idrilirdi/E-TKT/_electronic/kicad-lib/README.md

# Third-party KiCad libraries

- `Seeed_Studio_XIAO_Series.kicad_sym` and
  `Seeed_XIAO.pretty/XIAO-ESP32-C5-SMD.kicad_mod` come from
  [Seeed-Studio/OPL_Kicad_Library](https://github.com/Seeed-Studio/OPL_Kicad_Library),
  licensed CC-BY-SA-4.0.
