idrilirdi/E-TKT/docs/credits/libraries.md

---
layout: default
title: 📚 libraries
nav_order: 1
description: "E-TKT"
parent: 🏅 credits
---

# 📚 **libraries**

----

### Framework
- Arduino

### Environment
- Seeed XIAO ESP32-C5, [pioarduino platform-espressif32](https://github.com/pioarduino/platform-espressif32) 55.03.311 (arduino-esp32 3.3.11)

### Libraries
- [waspinator/AccelStepper@1.64](https://github.com/waspinator/AccelStepper )
- [madhephaestus/ESP32Servo@3.2.1](https://github.com/madhephaestus/ESP32Servo )
- [ESP32Async/ESPAsyncWebServer@3.12.1](https://github.com/ESP32Async/ESPAsyncWebServer)
- [ESP32Async/AsyncTCP@3.5.0](https://github.com/ESP32Async/AsyncTCP)
- [alanswx/ESPAsyncWiFiManager@0.31](https://github.com/alanswx/ESPAsyncWiFiManager)
- [olikraus/U8g2@2.36.18](https://github.com/olikraus/U8g2)
- [ricmoo/QRCode@0.0.1](https://github.com/ricmoo/QRCode) 
- [bblanchon/ArduinoJson@6.21.6](https://github.com/bblanchon/ArduinoJson)
- [ayushsharma82/ElegantOTA@3.1.7](https://github.com/ayushsharma82/ElegantOTA)

A big thank you for the library developers!
