idrilirdi/E-TKT/_electronic/e-tkt.kicad_pcb

## KiCad design _electronic/e-tkt.kicad_pcb (2026-11-04)

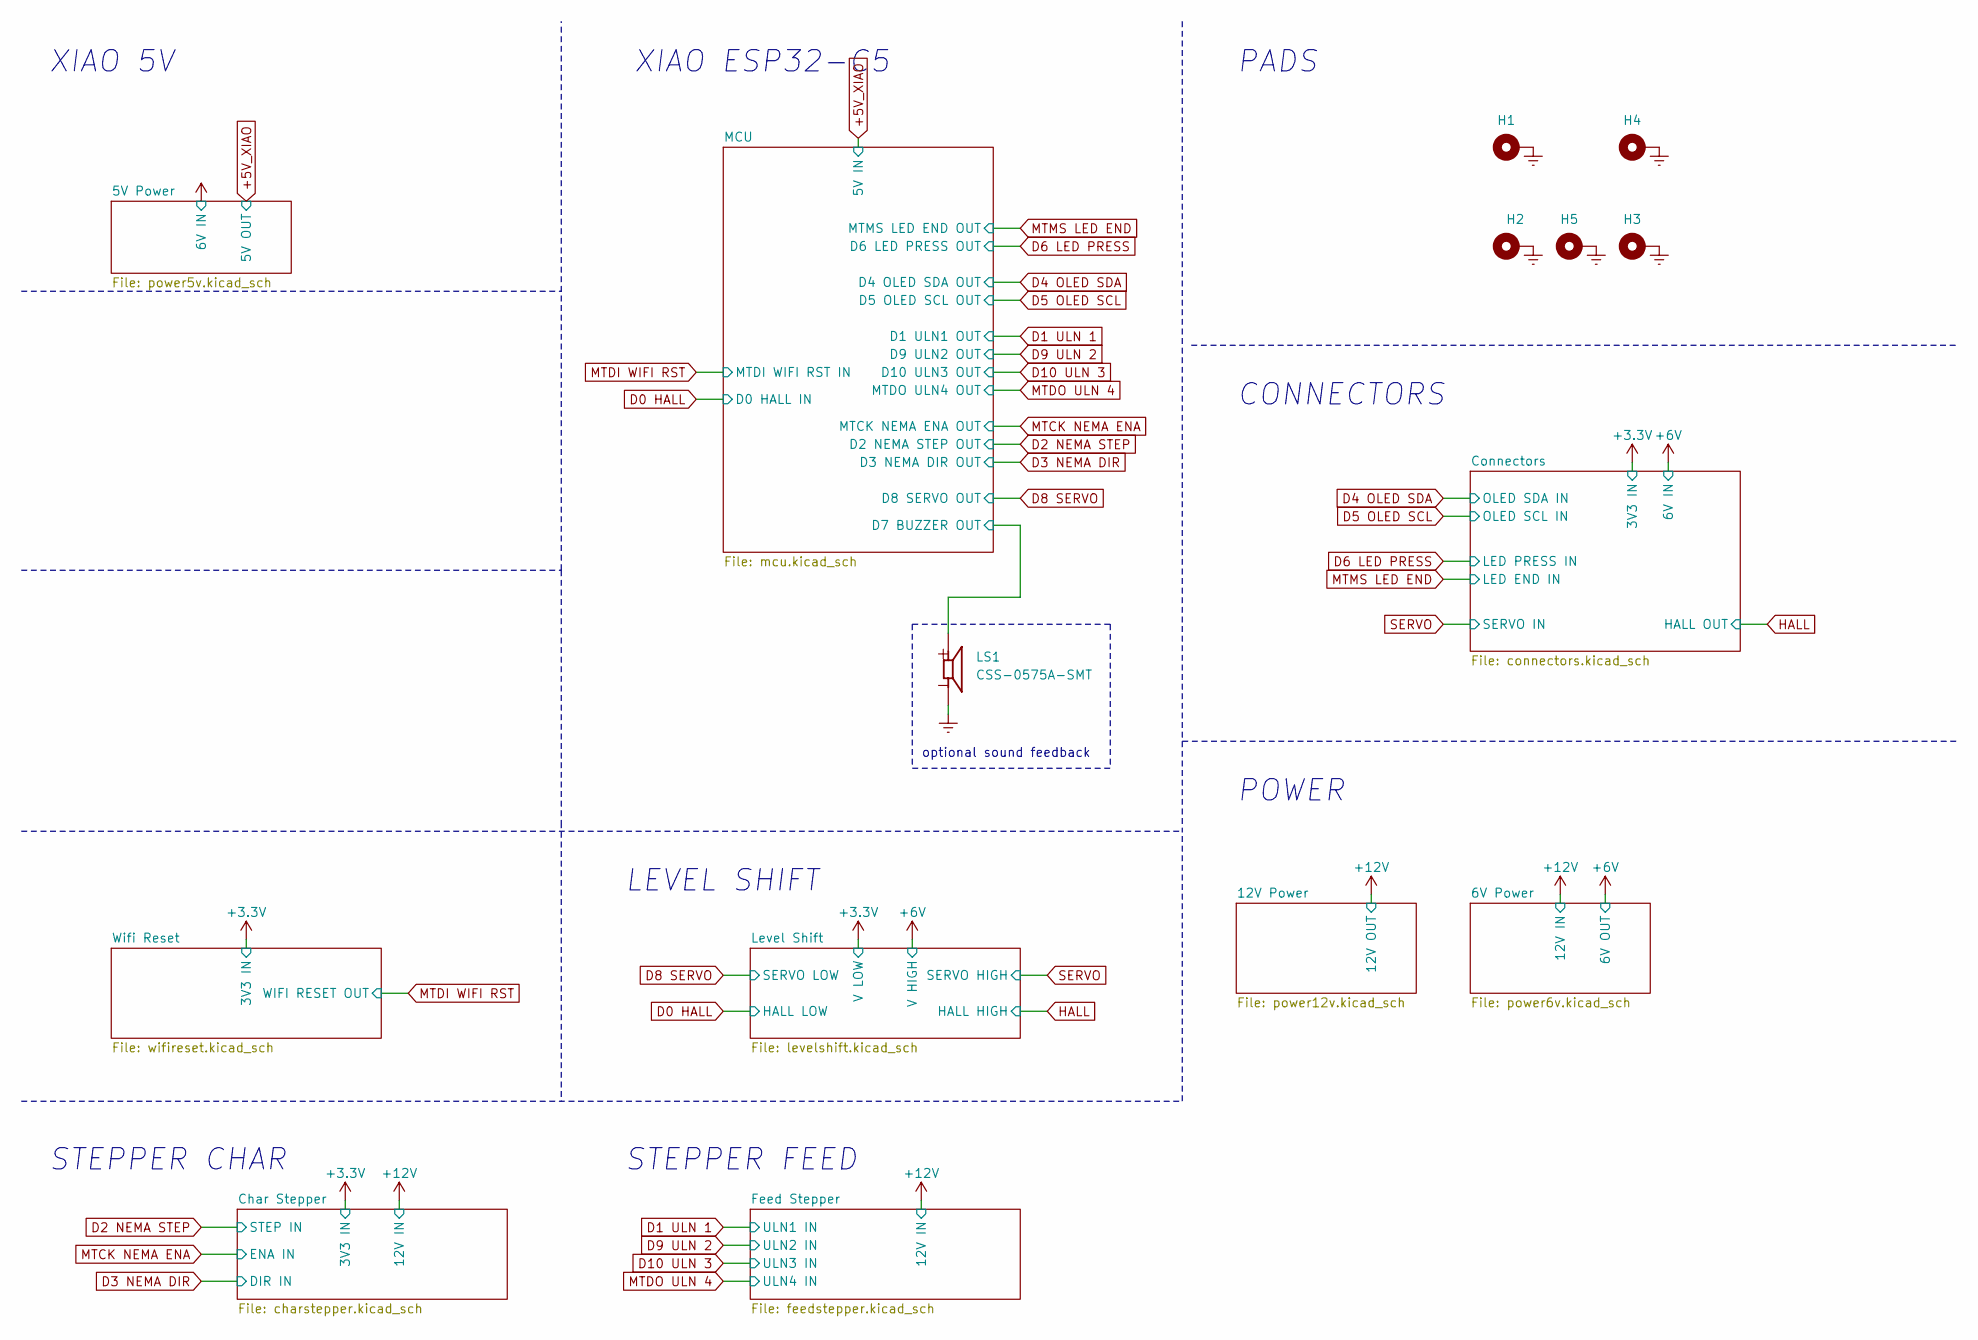
[picture p4: schematic e-tkt.kicad_sch, E-TKT v1.0]

Parts:
H1, H2, H3, H4, H5: M3; MountingHole_3.2mm_M3_Pad_Via; Mouser OK
LS1: CSS-0575A-SMT; CUI_CSS-0575A-SMT; Mouser OK

Connections:
/MCU/D7 BUZZER OUT: LS1.1; also elsewhere on the board
GNDREF: H1.1, H2.1, H3.1, H4.1, H5.1, LS1.2; also elsewhere on the board

Notes on the sheet:
PADS
POWER
optional sound feedback
CONNECTORS
STEPPER CHAR
XIAO ESP32-C5
LEVEL SHIFT
STEPPER FEED
XIAO 5V

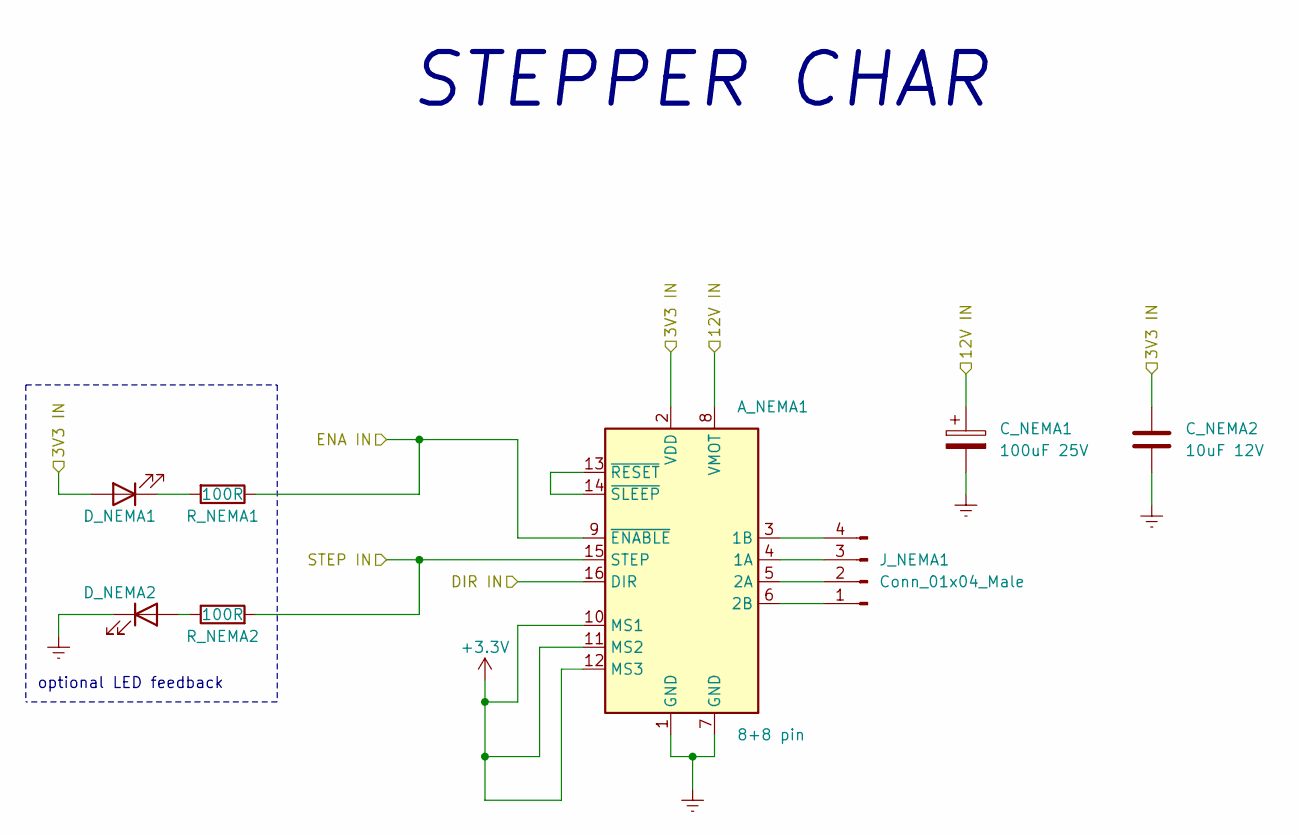
[picture p5: schematic charstepper.kicad_sch, E-TKT v1.0]

Parts:
A_NEMA1: 8+8 pin; Pololu_Breakout-16_15.2x20.3mm; Mouser OK
C_NEMA1: 100uF 25V; CP_Elec_6.3x7.7; Mouser OK
C_NEMA2: 10uF 12V; C_0603_1608Metric_Pad1.08x0.95mm_HandSolder; Mouser OK
D_NEMA1, D_NEMA2: LED white; LED_0603_1608Metric_Pad1.05x0.95mm_HandSolder; Mouser OK
J_NEMA1: Conn_01x04_Male; PinHeader_1x04_P2.54mm_Horizontal; Mouser OK
R_NEMA1, R_NEMA2: 100R; R_0603_1608Metric_Pad0.98x0.95mm_HandSolder; Mouser OK

Connections:
+3.3V: A_NEMA1.2 (VDD), A_NEMA1.10 (MS1), A_NEMA1.11 (MS2), A_NEMA1.12 (MS3), C_NEMA2.2, D_NEMA1.2 (A); also elsewhere on the board
+12V: A_NEMA1.8 (VMOT), C_NEMA1.1; also elsewhere on the board
D2 NEMA STEP: A_NEMA1.15 (STEP), R_NEMA2.2; also elsewhere on the board
D3 NEMA DIR: A_NEMA1.16 (DIR); also elsewhere on the board
GNDREF: A_NEMA1.1 (GND), A_NEMA1.7 (GND), C_NEMA1.2, C_NEMA2.1, D_NEMA2.1 (K); also elsewhere on the board
MTCK NEMA ENA: A_NEMA1.9 (~ENABLE), R_NEMA1.1; also elsewhere on the board
unnamed: A_NEMA1.4 (1A), J_NEMA1.3
unnamed: A_NEMA1.3 (1B), J_NEMA1.4
unnamed: A_NEMA1.5 (2A), J_NEMA1.2
unnamed: A_NEMA1.6 (2B), J_NEMA1.1
unnamed: A_NEMA1.13 (~RESET), A_NEMA1.14 (~SLEEP)
unnamed: D_NEMA1.1 (K), R_NEMA1.2
unnamed: D_NEMA2.2 (A), R_NEMA2.1

Notes on the sheet:
optional LED feedback
STEPPER CHAR

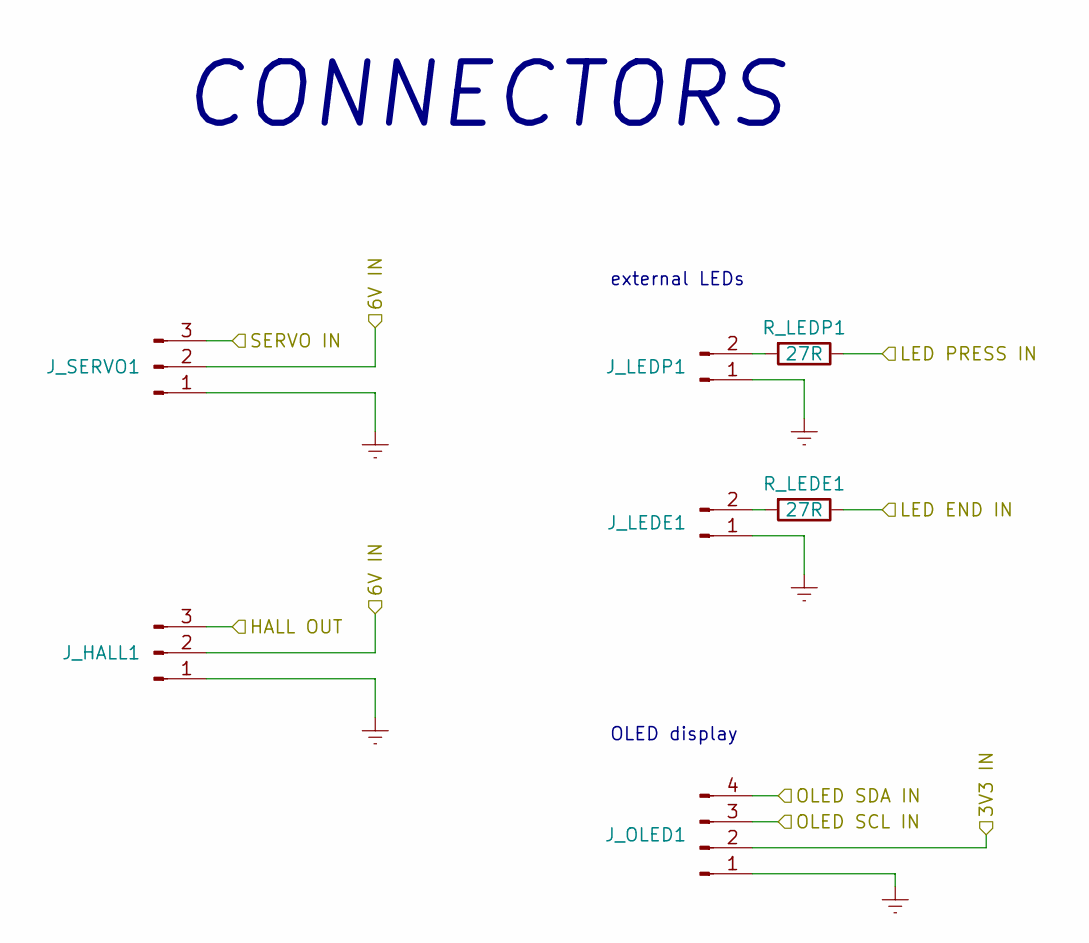
[picture p6: schematic connectors.kicad_sch, E-TKT v1.0]

Parts:
J_HALL1: Conn_01x03_Female; PinHeader_1x03_P2.54mm_Vertical; Mouser OK
J_LEDE1: Conn_01x02_Male; PinHeader_1x02_P2.54mm_Vertical; Mouser OK
J_LEDP1: Conn_01x02_Male; PinHeader_1x02_P2.54mm_Vertical; Mouser OK
J_OLED1: Conn_01x04_Male; PinHeader_1x04_P2.54mm_Vertical; Mouser OK
J_SERVO1: Conn_01x03_Male; PinHeader_1x03_P2.54mm_Vertical; Mouser OK
R_LEDE1: 27R; R_0603_1608Metric_Pad0.98x0.95mm_HandSolder; Mouser OK
R_LEDP1: 27R; R_0603_1608Metric_Pad0.98x0.95mm_HandSolder; Mouser OK

Connections:
+3.3V: J_OLED1.2; also elsewhere on the board
+6V: J_HALL1.2, J_SERVO1.2; also elsewhere on the board
D4 OLED SDA: J_OLED1.4; also elsewhere on the board
D5 OLED SCL: J_OLED1.3; also elsewhere on the board
D6 LED PRESS: R_LEDP1.1; also elsewhere on the board
GNDREF: J_HALL1.1, J_LEDE1.1, J_LEDP1.1, J_OLED1.1, J_SERVO1.1; also elsewhere on the board
HALL: J_HALL1.3; also elsewhere on the board
MTMS LED END: R_LEDE1.1; also elsewhere on the board
unnamed: J_LEDE1.2, R_LEDE1.2
unnamed: J_LEDP1.2, R_LEDP1.2
SERVO: J_SERVO1.3; also elsewhere on the board

Notes on the sheet:
OLED display
CONNECTORS
external LEDs

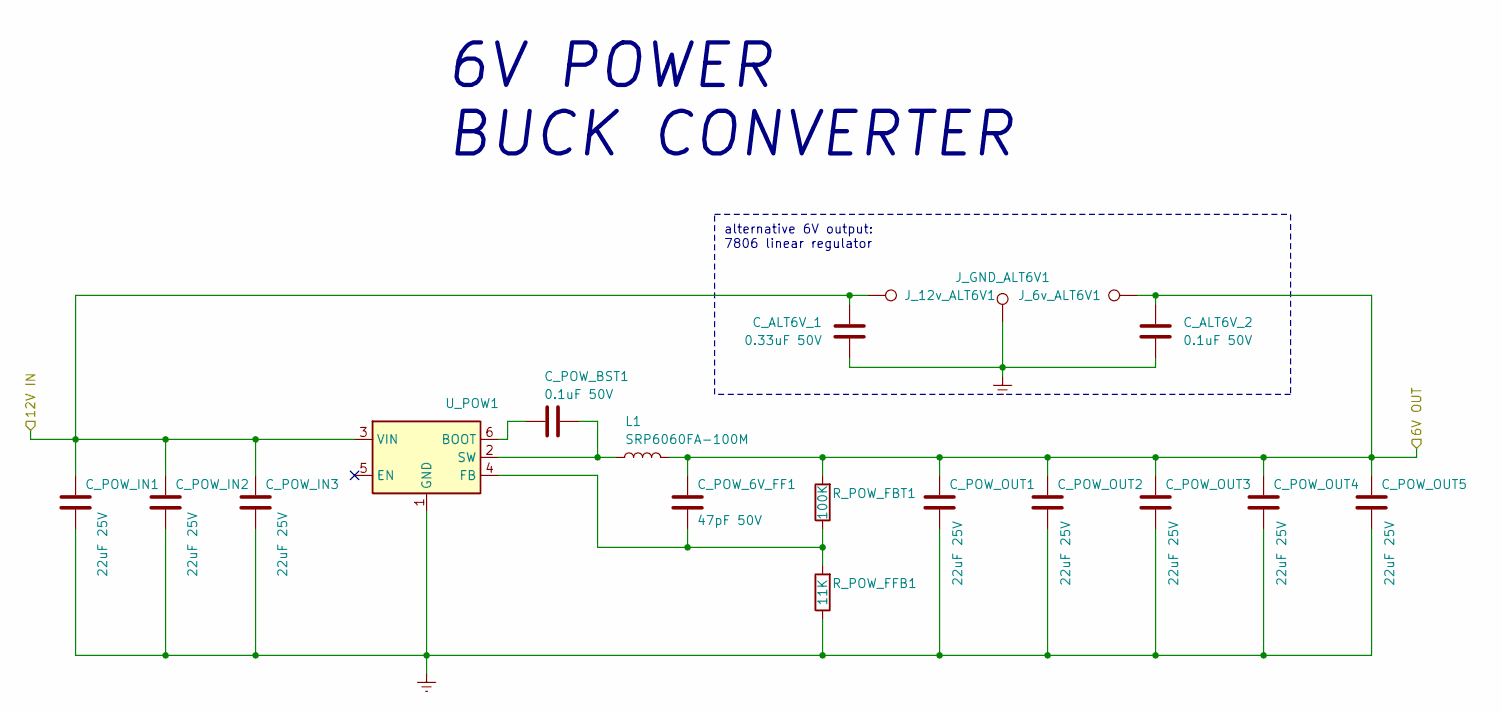
[picture p7: schematic power6v.kicad_sch, E-TKT v1.0]

Parts:
C_ALT6V_1: 0.33uF 50V; C_0603_1608Metric_Pad1.08x0.95mm_HandSolder; Mouser OK
C_ALT6V_2: 0.1uF 50V; C_0603_1608Metric_Pad1.08x0.95mm_HandSolder; Mouser OK
C_POW_6V_FF1: 47pF 50V; C_0603_1608Metric_Pad1.08x0.95mm_HandSolder; Mouser OK
C_POW_BST1: 0.1uF 50V; C_0603_1608Metric_Pad1.08x0.95mm_HandSolder; Mouser OK
C_POW_IN1, C_POW_IN2, C_POW_IN3: 22uF 25V; C_1210_3225Metric_Pad1.33x2.70mm_HandSolder; Mouser OK
C_POW_OUT1, C_POW_OUT2, C_POW_OUT3, C_POW_OUT4, C_POW_OUT5: 22uF 25V; C_1210_3225Metric_Pad1.33x2.70mm_HandSolder; Mouser OK
J_6v_ALT6V1, J_12v_ALT6V1: TestPoint; TestPoint_Pad_D1.5mm; Mouser OK
J_GND_ALT6V1: TestPoint; TestPoint_Pad_D1.5mm; Mouser OK
L1: SRP6060FA-100M; SRP6060FA-4R7M; Mouser OK
R_POW_FBT1: 100K; R_0603_1608Metric_Pad0.98x0.95mm_HandSolder; Mouser OK
R_POW_FFB1: 11K; R_0603_1608Metric_Pad0.98x0.95mm_HandSolder; Mouser OK
U_POW1: SOT-23-6_Handsoldering; Mouser N

Connections:
+6V: C_ALT6V_2.1, C_POW_6V_FF1.1, C_POW_OUT1.1, C_POW_OUT2.1, C_POW_OUT3.1, C_POW_OUT4.1, C_POW_OUT5.1, J_6v_ALT6V1.1, L1.2, R_POW_FBT1.2; also elsewhere on the board
+12V: C_ALT6V_1.2, C_POW_IN1.1, C_POW_IN2.1, C_POW_IN3.1, J_12v_ALT6V1.1, U_POW1.3 (VIN); also elsewhere on the board
GNDREF: C_ALT6V_1.1, C_ALT6V_2.2, C_POW_IN1.2, C_POW_IN2.2, C_POW_IN3.2, C_POW_OUT1.2, C_POW_OUT2.2, C_POW_OUT3.2, C_POW_OUT4.2, C_POW_OUT5.2, J_GND_ALT6V1.1, R_POW_FFB1.1, U_POW1.1 (GND); also elsewhere on the board
unnamed: C_POW_BST1.1, U_POW1.6 (BOOT)
unnamed: C_POW_6V_FF1.2, R_POW_FBT1.1, R_POW_FFB1.2, U_POW1.4 (FB)
unnamed: C_POW_BST1.2, L1.1, U_POW1.2 (SW)

Notes on the sheet:
alternative 6V output: 7806 linear regulator
6V POWER BUCK CONVERTER

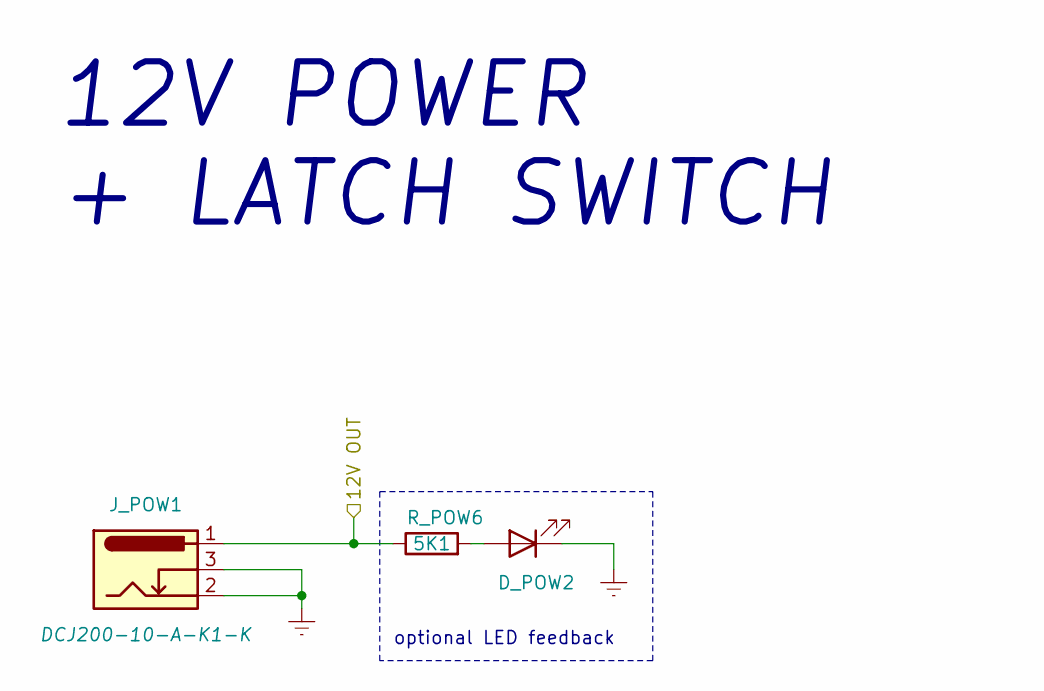
[picture p8: schematic power12v.kicad_sch, E-TKT v1.0]

Parts:
D_POW2: LED white; LED_0603_1608Metric_Pad1.05x0.95mm_HandSolder; Mouser OK
J_POW1: Barrel_Jack_Switch; BarrelJack_GCT_DCJ200-10-A_Horizontal; Mouser OK
R_POW6: 5K1; R_0603_1608Metric_Pad0.98x0.95mm_HandSolder; Mouser OK

Connections:
+12V: J_POW1.1, R_POW6.1; also elsewhere on the board
GNDREF: D_POW2.1 (K), J_POW1.2, J_POW1.3; also elsewhere on the board
unnamed: D_POW2.2 (A), R_POW6.2

Notes on the sheet:
optional LED feedback
12V POWER + LATCH SWITCH

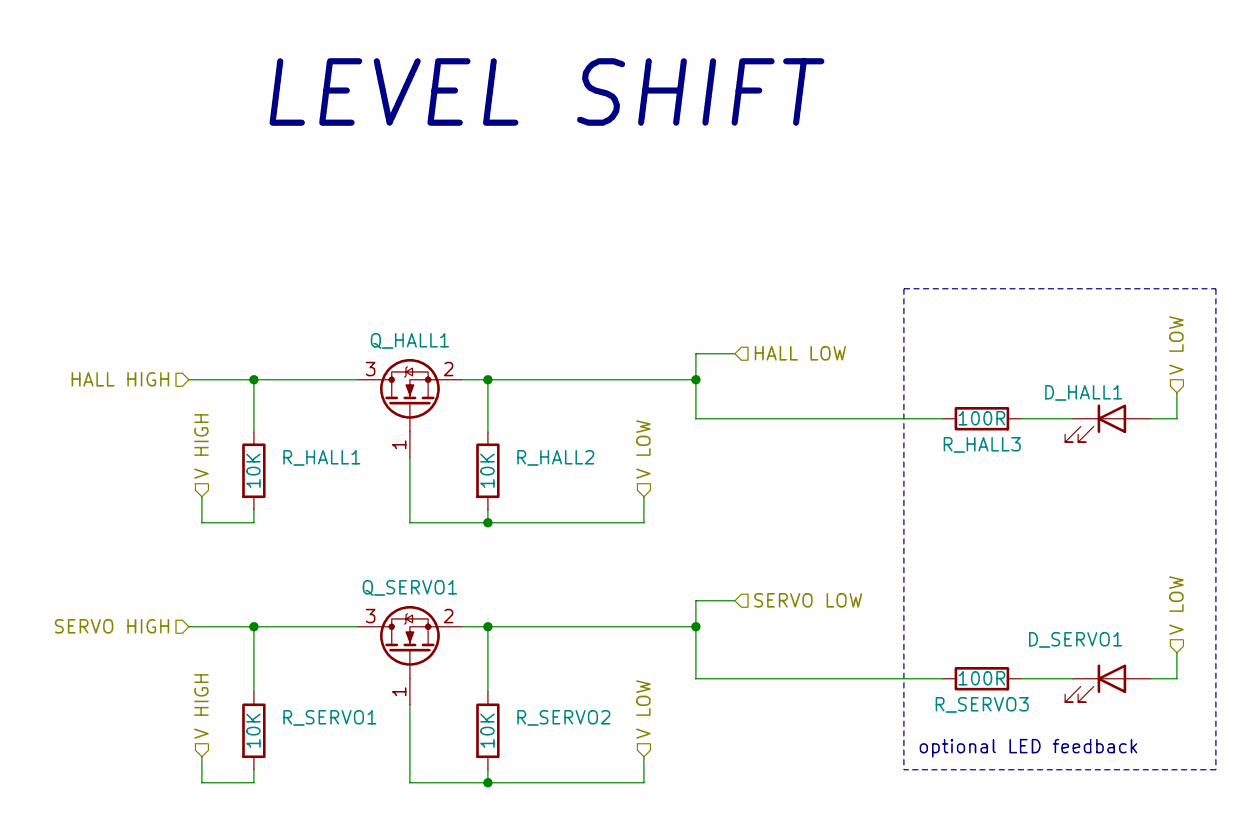
[picture p9: schematic levelshift.kicad_sch, E-TKT v1.0]

Parts:
D_HALL1: LED white; LED_0603_1608Metric_Pad1.05x0.95mm_HandSolder; Mouser OK
D_SERVO1: LED white; LED_0603_1608Metric_Pad1.05x0.95mm_HandSolder; Mouser OK
Q_HALL1: BSS138LT3G; SOT-23_Handsoldering; Mouser OK
Q_SERVO1: BSS138LT3G; SOT-23_Handsoldering; Mouser OK
R_HALL1, R_HALL2: 10K; R_0603_1608Metric_Pad0.98x0.95mm_HandSolder; Mouser OK
R_HALL3: 100R; R_0603_1608Metric_Pad0.98x0.95mm_HandSolder; Mouser OK
R_SERVO1, R_SERVO2: 10K; R_0603_1608Metric_Pad0.98x0.95mm_HandSolder; Mouser OK
R_SERVO3: 100R; R_0603_1608Metric_Pad0.98x0.95mm_HandSolder; Mouser OK

Connections:
+3.3V: D_HALL1.2 (A), D_SERVO1.2 (A), Q_HALL1.1 (G), Q_SERVO1.1 (G), R_HALL2.2, R_SERVO2.2; also elsewhere on the board
+6V: R_HALL1.2, R_SERVO1.2; also elsewhere on the board
D0 HALL: Q_HALL1.2 (S), R_HALL2.1, R_HALL3.1; also elsewhere on the board
D8 SERVO: Q_SERVO1.2 (S), R_SERVO2.1, R_SERVO3.1; also elsewhere on the board
HALL: Q_HALL1.3 (D), R_HALL1.1; also elsewhere on the board
unnamed: D_HALL1.1 (K), R_HALL3.2
unnamed: D_SERVO1.1 (K), R_SERVO3.2
SERVO: Q_SERVO1.3 (D), R_SERVO1.1; also elsewhere on the board

Notes on the sheet:
optional LED feedback
LEVEL SHIFT

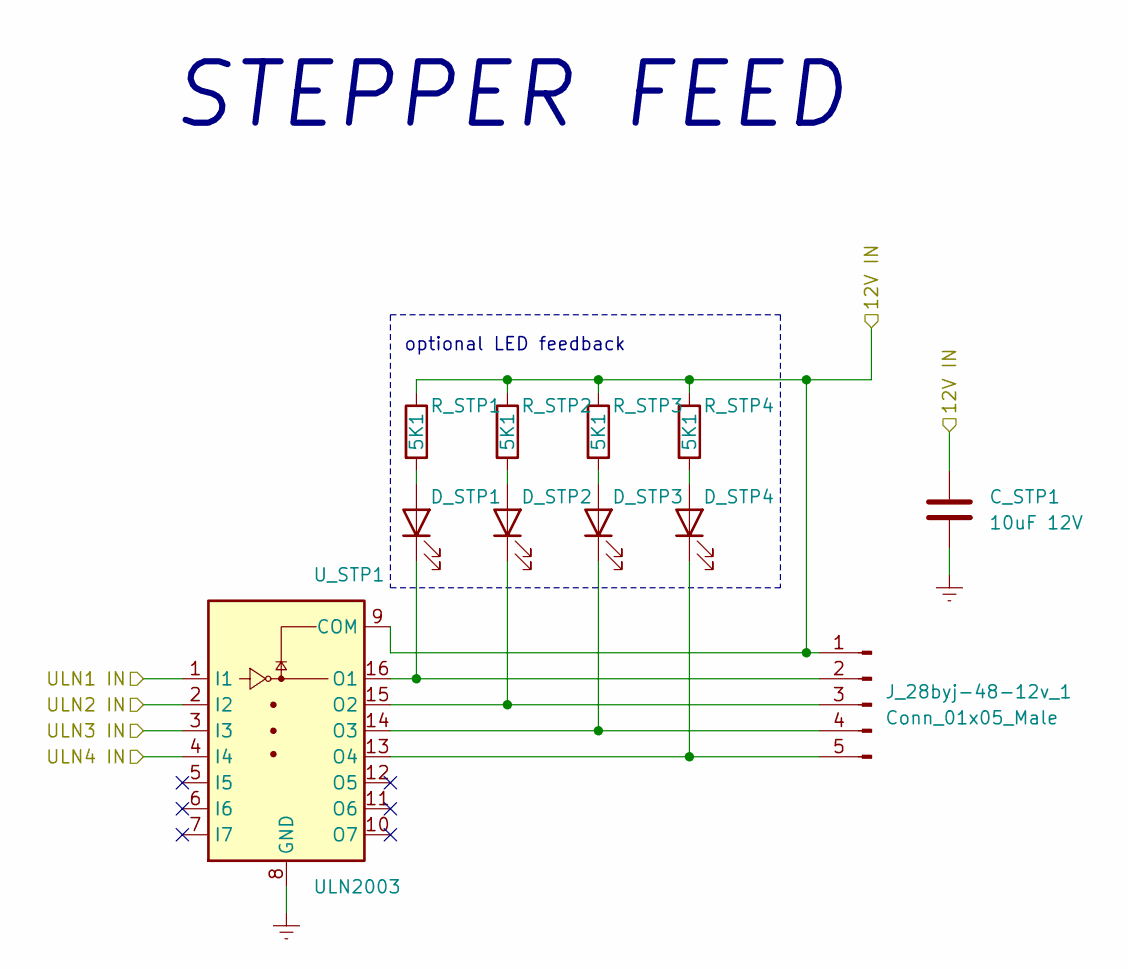
[picture p10: schematic feedstepper.kicad_sch, E-TKT v1.0]

Parts:
C_STP1: 10uF 12V; C_0603_1608Metric_Pad1.08x0.95mm_HandSolder; Mouser OK
D_STP1, D_STP2, D_STP3, D_STP4: LED white; LED_0603_1608Metric_Pad1.05x0.95mm_HandSolder; Mouser OK
J_28byj-48-12v_1: Conn_01x05_Male; PinHeader_1x05_P2.54mm_Vertical; Mouser OK
R_STP1, R_STP2, R_STP3, R_STP4: 5K1; R_0603_1608Metric_Pad0.98x0.95mm_HandSolder; Mouser OK
U_STP1: ULN2003; SOIC-16_3.9x9.9mm_P1.27mm; Mouser OK

Connections:
+12V: C_STP1.2, J_28byj-48-12v_1.1, R_STP1.1, R_STP2.1, R_STP3.1, R_STP4.1, U_STP1.9 (COM); also elsewhere on the board
D1 ULN 1: U_STP1.1 (I1); also elsewhere on the board
D9 ULN 2: U_STP1.2 (I2); also elsewhere on the board
D10 ULN 3: U_STP1.3 (I3); also elsewhere on the board
GNDREF: C_STP1.1, U_STP1.8 (GND); also elsewhere on the board
MTDO ULN 4: U_STP1.4 (I4); also elsewhere on the board
unnamed: D_STP1.2 (A), R_STP1.2
unnamed: D_STP1.1 (K), J_28byj-48-12v_1.2, U_STP1.16 (O1)
unnamed: D_STP2.2 (A), R_STP2.2
unnamed: D_STP2.1 (K), J_28byj-48-12v_1.3, U_STP1.15 (O2)
unnamed: D_STP3.2 (A), R_STP3.2
unnamed: D_STP3.1 (K), J_28byj-48-12v_1.4, U_STP1.14 (O3)
unnamed: D_STP4.2 (A), R_STP4.2
unnamed: D_STP4.1 (K), J_28byj-48-12v_1.5, U_STP1.13 (O4)

Notes on the sheet:
optional LED feedback
STEPPER FEED

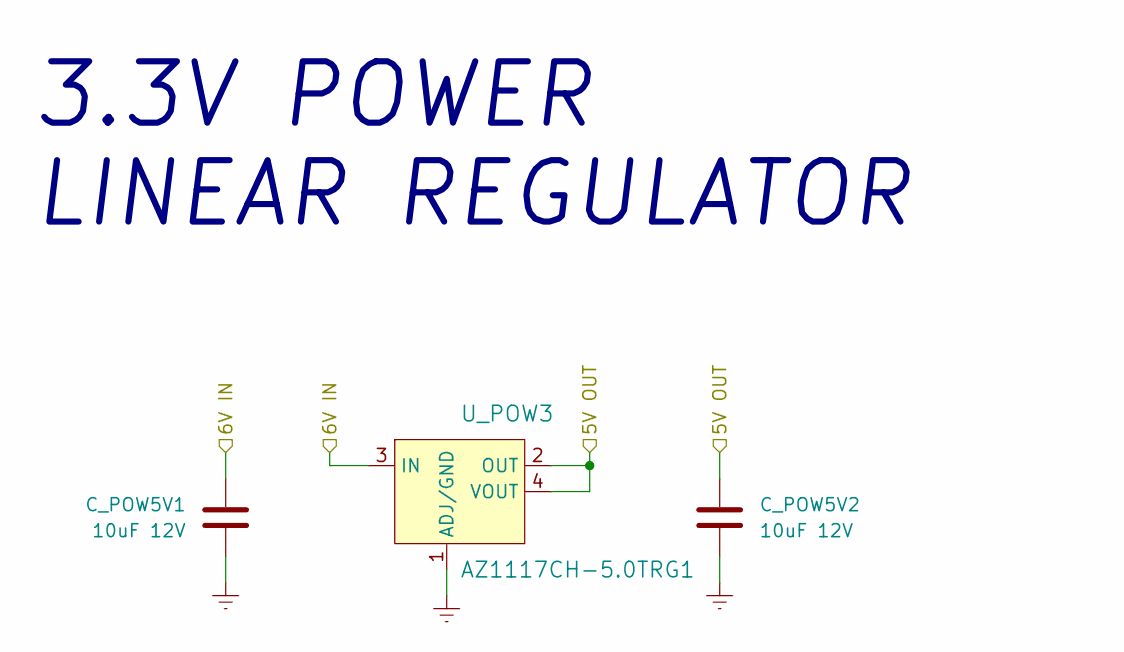
[picture p11: schematic power5v.kicad_sch, E-TKT v1.0]

Parts:
C_POW5V1, C_POW5V2: 10uF 12V; C_0603_1608Metric_Pad1.08x0.95mm_HandSolder; Mouser OK
U_POW3: AZ1117CH-5.0TRG1; SOT-223; Mouser OK

Connections:
+5V_XIAO: C_POW5V2.1, U_POW3.2 (OUT), U_POW3.4 (VOUT); also elsewhere on the board
+6V: C_POW5V1.1, U_POW3.3 (IN); also elsewhere on the board
GNDREF: C_POW5V1.2, C_POW5V2.2, U_POW3.1 (ADJ/GND); also elsewhere on the board

Notes on the sheet:
3.3V POWER LINEAR REGULATOR

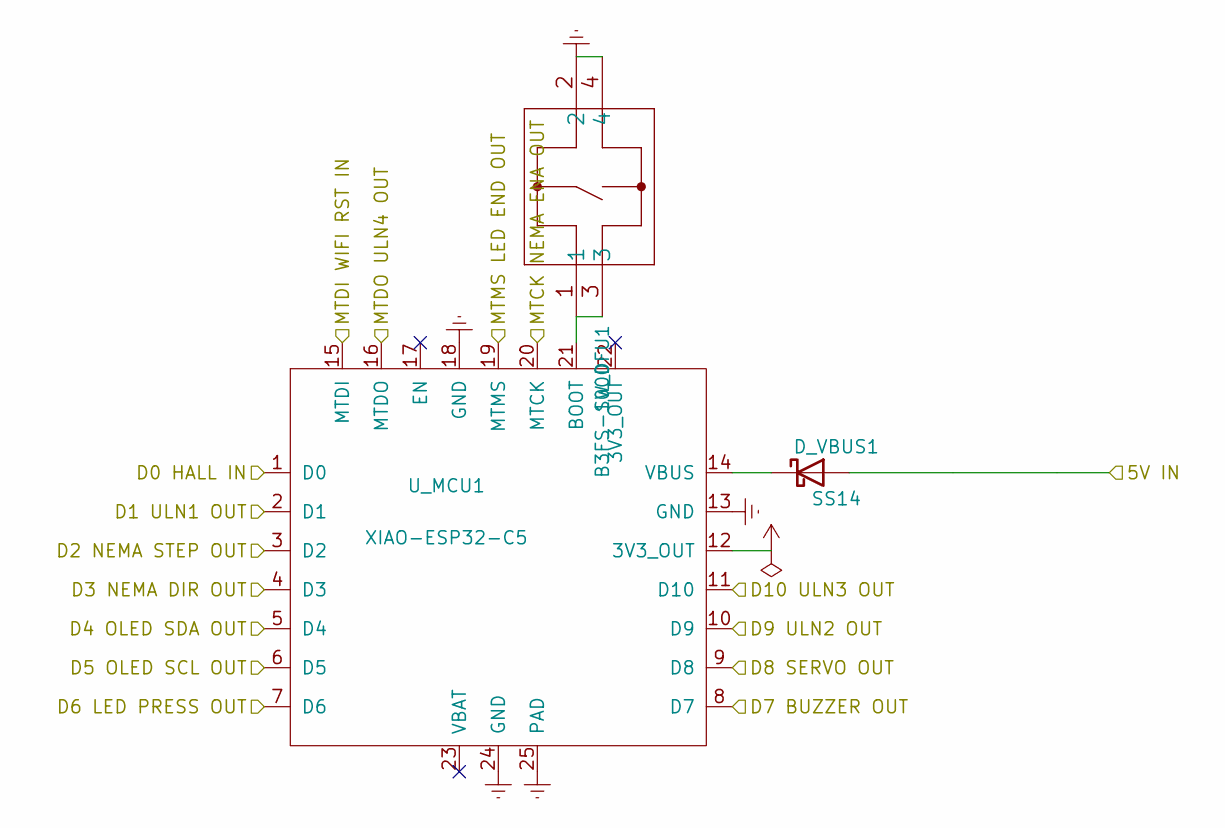
[picture p12: schematic mcu.kicad_sch, E-TKT v1.0]

Parts:
D_VBUS1: SS14; D_SMA
SW_DFU1: B3FS-1000
U_MCU1: XIAO-ESP32-C5; XIAO-ESP32-C5-SMD

Connections:
+3.3V: U_MCU1.12 (3V3_OUT); also elsewhere on the board
+5V_XIAO: D_VBUS1.2 (A); also elsewhere on the board
/MCU/D7 BUZZER OUT: U_MCU1.8 (D7); also elsewhere on the board
D0 HALL: U_MCU1.1 (D0); also elsewhere on the board
D1 ULN 1: U_MCU1.2 (D1); also elsewhere on the board
D2 NEMA STEP: U_MCU1.3 (D2); also elsewhere on the board
D3 NEMA DIR: U_MCU1.4 (D3); also elsewhere on the board
D4 OLED SDA: U_MCU1.5 (D4); also elsewhere on the board
D5 OLED SCL: U_MCU1.6 (D5); also elsewhere on the board
D6 LED PRESS: U_MCU1.7 (D6); also elsewhere on the board
D8 SERVO: U_MCU1.9 (D8); also elsewhere on the board
D9 ULN 2: U_MCU1.10 (D9); also elsewhere on the board
D10 ULN 3: U_MCU1.11 (D10); also elsewhere on the board
GNDREF: SW_DFU1.2, SW_DFU1.4, U_MCU1.13 (GND), U_MCU1.18 (GND), U_MCU1.24 (GND), U_MCU1.25 (PAD); also elsewhere on the board
MTCK NEMA ENA: U_MCU1.20 (MTCK); also elsewhere on the board
MTDI WIFI RST: U_MCU1.15 (MTDI); also elsewhere on the board
MTDO ULN 4: U_MCU1.16 (MTDO); also elsewhere on the board
MTMS LED END: U_MCU1.19 (MTMS); also elsewhere on the board
unnamed: D_VBUS1.1 (K), U_MCU1.14 (VBUS)
unnamed: SW_DFU1.1, SW_DFU1.3, U_MCU1.21 (BOOT)

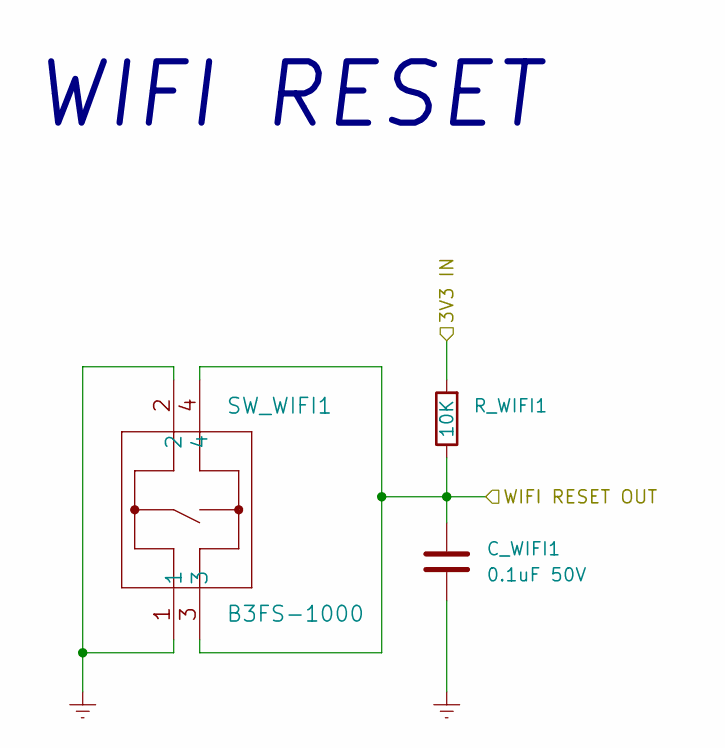
[picture p13: schematic wifireset.kicad_sch, E-TKT v1.0]

Parts:
C_WIFI1: 0.1uF 50V; C_0603_1608Metric_Pad1.08x0.95mm_HandSolder; Mouser OK
R_WIFI1: 10K; R_0603_1608Metric_Pad0.98x0.95mm_HandSolder; Mouser OK
SW_WIFI1: B3FS-1000; Mouser OK

Connections:
+3.3V: R_WIFI1.2; also elsewhere on the board
GNDREF: C_WIFI1.1, SW_WIFI1.1, SW_WIFI1.2; also elsewhere on the board
MTDI WIFI RST: C_WIFI1.2, R_WIFI1.1, SW_WIFI1.3, SW_WIFI1.4; also elsewhere on the board

Notes on the sheet:
WIFI RESET

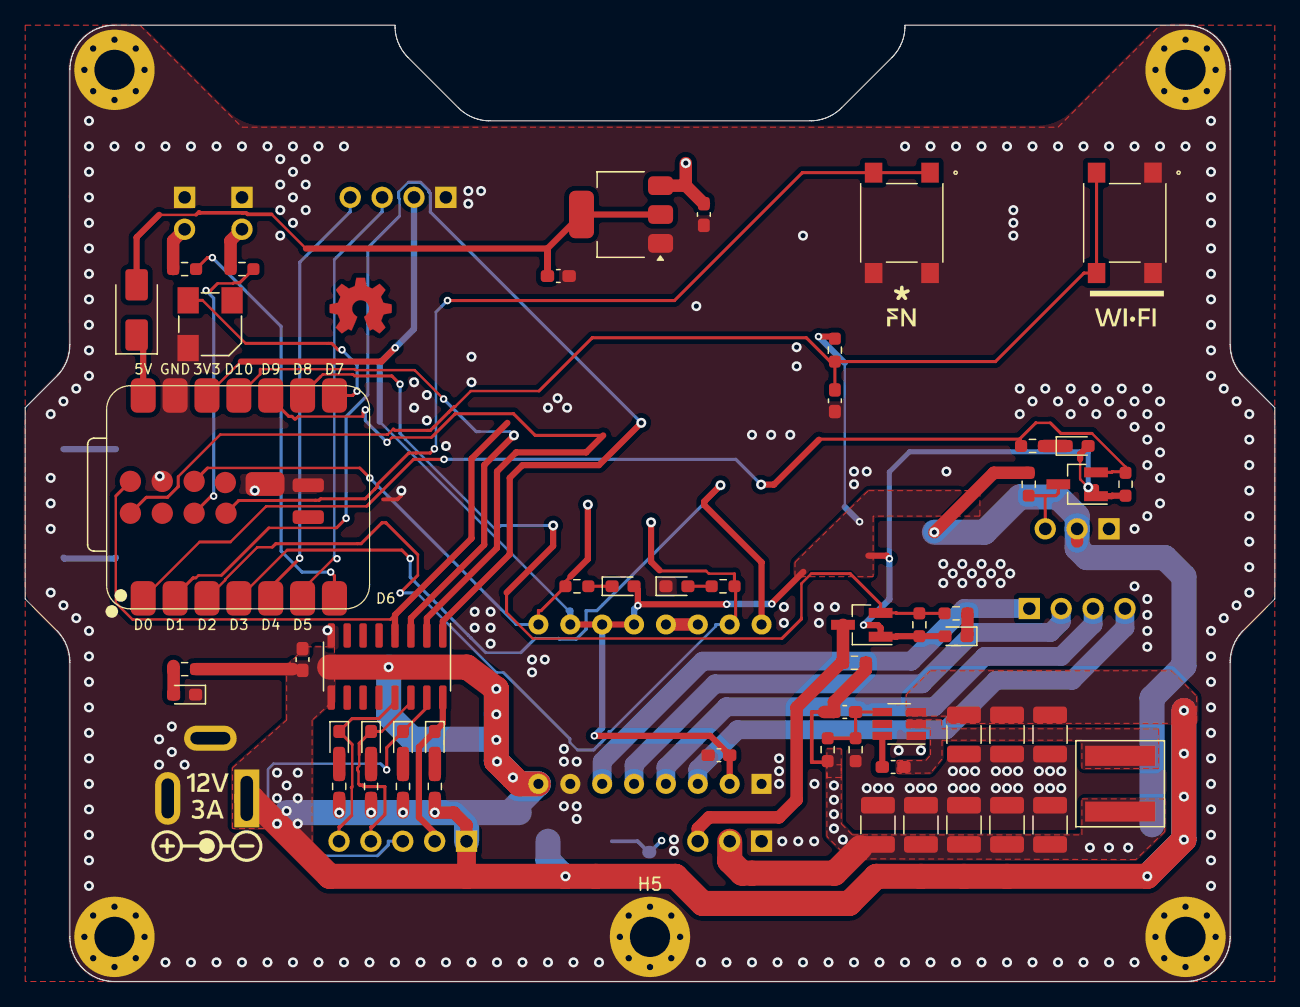
[picture p14: board e-tkt.kicad_pcb from above]

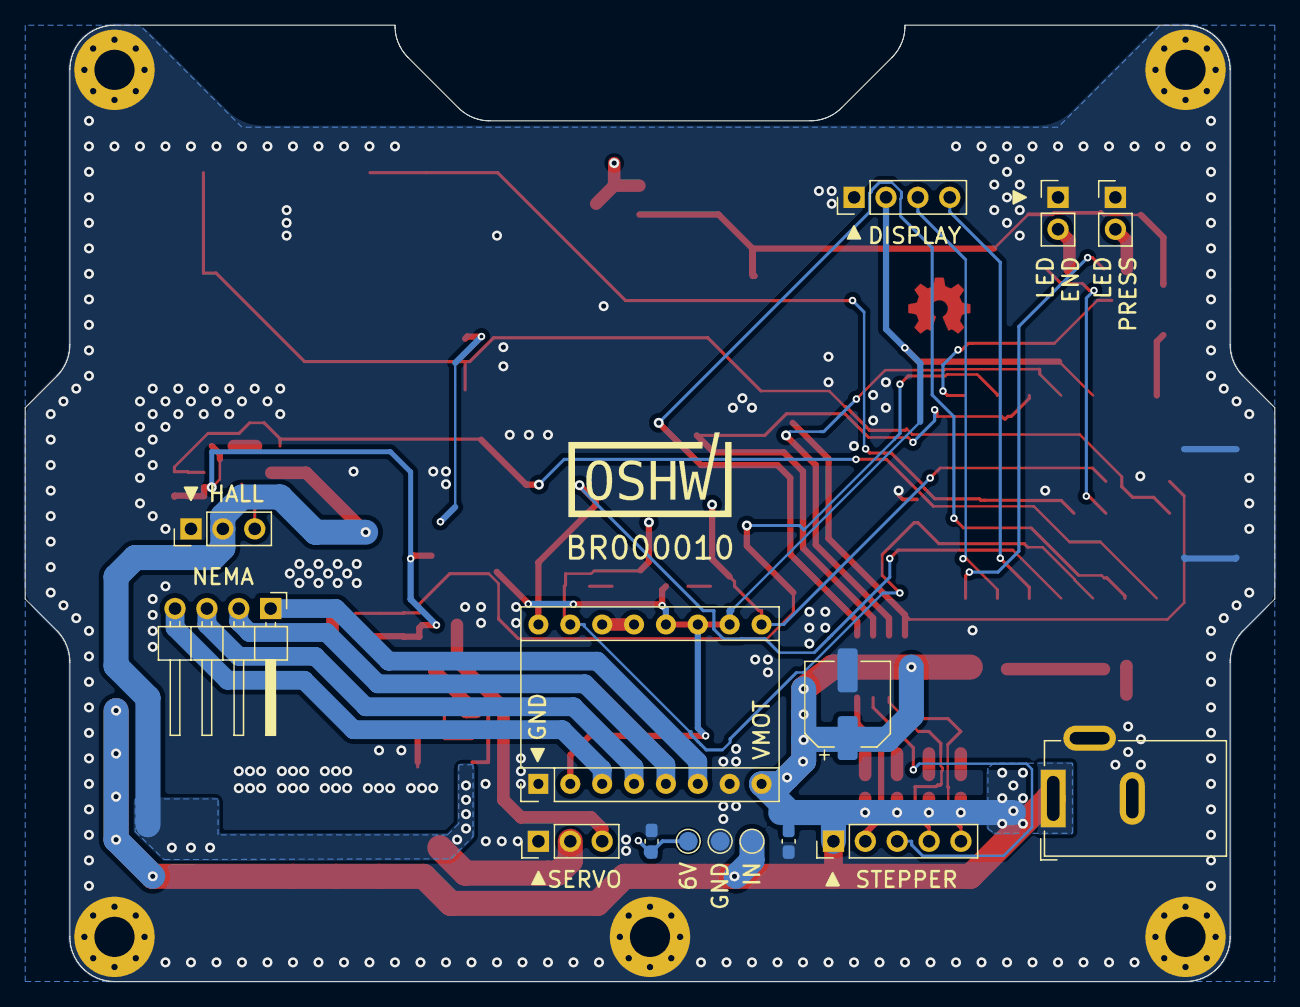
[picture p15: board e-tkt.kicad_pcb from below]

Board: 4 copper layers, 99.6 x 76.2 mm, 73 parts (15 on the bottom side), 47 nets.
