idrilirdi/E-TKT/src/LabelMaker.cpp

// MIT License

// Copyright (c) 2022 Andrei Speridião

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
//
// for more information, please visit https://github.com/andreisperid/E-TKT
//

// vvvvvvvvvvvvvvvvvvvvvvvvvvvvvvvvvvvvvvvvvvvvvvvvvvvvvvvvvvvvvvvvvvvvvvvvvv
//
// IMPORTANT: do not forget to upload the files in "data" folder using SPIFFS
//
// ^^^^^^^^^^^^^^^^^^^^^^^^^^^^^^^^^^^^^^^^^^^^^^^^^^^^^^^^^^^^^^^^^^^^^^^^^^

#include <Arduino.h>

#include "DaisyWheel.h"
#include "Characters.h"
#include "Configuration.h"
#include "Display.h"
#include "ETKT.h"
#include "Feeder.h"
#include "HallSwitch.h"
#include "Light.h"
#include "Logger.h"
#include "WebInterface.h"
#include "Press.h"
#include "Settings.h"
#include "Sound.h"
#include "Utility.h"

Logger* logger = new Logger();
Characters* characters = new Characters();
Sound* sound = new Sound(characters);
Display* display = new Display(sound, characters);
Settings* settings = new Settings(logger);
Light* ledFinish = new Light(FINISH_LED_PIN);
Light* ledChar = new Light(CHARACTER_LED_PIN);
Press* press = new Press(logger, SERVO_PIN, ledChar);
HallSwitch* hall = new HallSwitch(logger, HALL_PIN);
DaisyWheel* daisywheel = new DaisyWheel(logger, hall, characters, settings);
Feeder* feeder = new Feeder(logger);
ETKT* etkt = new ETKT(logger, settings, characters, display, daisywheel, hall,
                      feeder, press, sound, ledFinish, ledChar);
WebInterface* network = new WebInterface(logger, display, etkt, WIFI_RESET_PIN);

void setup() {
  // Initialize hardware
  etkt->initialize();

  // Play the splash screen
  display->playSplashScreen();

  // Start WiFi, network.
  network->initialize();

  // Display the ready "idle" screen.
  display->renderIdle();
}

void loop() {
  etkt->loop();
  network->loop();
}
