idrilirdi/E-TKT/src/WebInterface.h

#pragma once

#include <Arduino.h>
#include <AsyncTCP.h>
#include <ESPAsyncWebServer.h>
#include <ESPAsyncWiFiManager.h>
#include <ESPmDNS.h>
#include <WiFi.h>

#include "ArduinoJson.h"
#include "AsyncJson.h"
#include "Configuration.h"
#include "Display.h"
#include "ETKT.h"
#include "Logger.h"
#include "SPIFFS.h"
#include "esp_wifi.h"

/**
 * @brief Manages connection to the network. 
 * 
 * @details Handles:
 *  - Setting up WiFi credentials, including creating a soft AP for
 *    configuration
 *  - Serving the web interface and API endpoints
 *  - Advertising the device over MDNS.
 */
class WebInterface {
 private:
  // A hacky static workaround to make the softAPCallbackStatic method work.
  // Needed because of how the ESPAsyncWiFiManager library works.
  static WebInterface *instance;

  Logger *logger;
  AsyncWebServer *server;
  DNSServer *dns;
  Display *display;
  ETKT *etkt;

  // WiFi reset button pin
  uint8_t resetPin;

  /**
   * @brief A callback for when the captive portal is started.
   */
  void softAPCallback(AsyncWiFiManager *wifi);
  static void softAPCallbackStatic(AsyncWiFiManager *myAsyncWiFiManager);

  /*
   * @brief Clears stored wifi credentials in response to a button press.
   */
  void clearWiFiCredentials();

  /**
   * Callbacks to handle each type of command form the webapp.
   */
  void cutPostHandler(AsyncWebServerRequest *request);
  void reelPostHandler(AsyncWebServerRequest *request);
  void feedPostHandler(AsyncWebServerRequest *request);
  void savePostHandler(AsyncWebServerRequest *request, JsonVariant &json);
  void testAlignPostHandler(AsyncWebServerRequest *request, JsonVariant &json);
  void testFullPostHandler(AsyncWebServerRequest *request, JsonVariant &json);
  void homePostHandler(AsyncWebServerRequest *request);
  void movePostHandler(AsyncWebServerRequest *request, JsonVariant &json);
  void tagPostHandler(AsyncWebServerRequest *request, JsonVariant &json);
  void statusGetHandler(AsyncWebServerRequest *request);
  void notFoundHandler(AsyncWebServerRequest *request);

 public:
  WebInterface(Logger *logger, Display *display, ETKT *etkt, uint8_t resetPin);
  ~WebInterface();

  /**
   * Connects to the network, starts the captive portal if necessary, and starst
   * the webapp's server.
   */
  void initialize();

  /**
   * Services the OTA updater, which reboots the device after a finished update.
   */
  void loop();
};
