idrilirdi/E-TKT/(commit log)

2026-11-04 feat(electronics): replace ESP32-WROOM-32D with Seeed XIAO ESP32-C5
    The XIAO brings its own USB-C, USB-serial, reset and BOOT buttons, so the
    USB-C, FT231XS serial, auto-reset and WiFi reset circuits go away.
    Project:
    - Files saved in the KiCad 10 format; the Seeed XIAO library needs it.
    KiCad 8+ names power nets from the symbol Value, so two GNDREF symbols
    in power6v with an empty Value got it set back to GNDREF (they would
    otherwise have disconnected the buck converter's ground pads).
    - Seeed's XIAO symbol and XIAO-ESP32-C5-SMD footprint (CC-BY-SA-4.0) in
    kicad-lib/, wired in through project library tables.
    - XIAO-C5.md documents the pin map and the board changes.
    Schematic:
    - U_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
    [boot.kicad_sch, charstepper.kicad_sch, connectors.kicad_sch, drafts.kicad_sch, e-tkt.kicad_pcb, e-tkt.kicad_sch, extflashing.kicad_sch, feedstepper.kicad_sch]
2026-11-04 feat(firmware): port to Seeed XIAO ESP32-C5
    Move the pin map to the XIAO pads (see _electronic/XIAO-C5.md) and build
    on arduino-esp32 3.3.11 through the pioarduino platform.
    - WiFi reset reads the WI-FI button, now on MTDI (GPIO3).
    - Feed stepper pins become PIN_FEED_ULN1..4 defines.
    - ESP32Servo 3.x: use the core tone() and analogWrite().
    - ESPAsyncWebServer and AsyncTCP from ESP32Async.
    - ElegantOTA 3 replaces AsyncElegantOTA; the upload script follows its
    /ota/start and /ota/upload protocol and loop() handles the reboot.
    - Rename Network to WebInterface, since core 3.x has its own Network.h
    and a global Network object.
    - Fix header case (Preferences.h) and the FreeRTOS include path.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
    [Configuration.h]
